devrintalen/adbusb/doc/references.md

References and Further Reading {#references}
==============================

I've broken this out into different sections. This first set of links
covers your basic introductory material for Apple Desktop Bus:

* http://en.wikipedia.org/wiki/Apple_Desktop_Bus
* http://www.microchip.com/stellent/idcplg?IdcService=SS_GET_PAGE&nodeId=1824&appnote=en011062
* http://mcosre.sourceforge.net/docs/adb_intro.html

This set of links is of other projects that have done similar things
with Apple Desktop Bus:

* http://geekhack.org/showwiki.php?title=Island:14290
* http://spritesmods.com/?art=macsearm&page=4
* https://github.com/tmk/tmk_keyboard

And this final set is of materials that are relevant to the USB
firmware and the AVR:

* http://www.obdev.at/products/vusb/hidkeys.html
* [Atmel AVR042: AVR Hardware Design Considerations](http://www.atmel.com/Images/doc2521.pdf) (pdf)
* http://www.usb.org/developers/docs/hidpage/
