devrintalen/adbusb/doc/keyboard_layout.rst

Keyboard Layout
---------------

      --------- function keys -----------
<esc> 1 2 3 4 5 6 7 8 9 10 11 12 13 14 15

~ 1 2 3 4 5 6 7 8 9 0 - + <del>         <help> <hom> <pgup>     <c> = / *
<tab> q w e r t y u i o p [ ] \         <del>  <end> <pgdn>     7 8 9 -
<cap> a s d f g h j k l ; ' <ret>                               4 5 6 +
<shift> z x c v b n m , . / <shift>        ^                    1 2 3 <ent>
<ctrl> <o> <c> <space> <c> <o> <ctrl>   <- v ->                 0   .

Keycodes
--------

35 7a 78 63 76 60 61 62 64 65 6d 67 6f 69 6b 71

32 12 13 14 15 17 16 1a 1c 19 1d 1b 18 33   72 73 74    47 51 4b 43
30 0c 0d 0e 0f 11 10 20 22 1f 23 21 1e 2a   75 77 79    59 5b 5c 4e
39 00 01 02 03 05 04 26 28 25 29 27 24                  56 57 58 45 
38 06 07 08 09 0b 2d 2e 2b 2f 2c 38            3e       53 54 55 4c
36 3a 37 31 37 3a 36                        3b 3d ??    52 41
