devrintalen/adbusb/(list of files, drawings)

Other design files:
schematic/board_mega32.pcb
