devrintalen/adbusb/code/main.c

// Copyright 2009 Devrin Talen
// This file is part of ADBUSB.
// 
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
/*! 
  \file main.c
  \brief Main program source.
*/

#include <stdlib.h>
#include <stdint.h>
#include <stdio.h>
#include <avr/wdt.h>

#include "adb.h"
#include "keyboard.h"
#include "uart.h"
#include "usb.h"

/// File handle to UART device
static FILE uart_str = FDEV_SETUP_STREAM(uart_putchar, NULL, _FDEV_SETUP_WRITE);

/*! \brief Reset entry point.
  
  At reset the device starts executing at this point. This will call
  initializers to disable the watch dog timer and enable the ADB and
  USB interfaces. The watch dog timer is a nice feature to have but it hasn't been necessary (yet) for this project.

  The function usb_init() handles all of the USB interface initialization. No other global state is necessary for 
  The ADB interface is set up by declaring and initializing the variables that the data returned by the keyboard. The adb_init() function is then called, which will handle the reset tasks on the line.


It then enters the main
  loop and polls the ADB device and sends data on the USB interface as
  needed.
*/
int main(void)
{
  // Initialize watchdog timer.
  wdt_disable();

  // Initialize USB.
  usb_init();

  // Initialize ADB.
  uint8_t adb_status = 0;
  uint8_t adb_len;
  uint8_t adb_data[8];
  adb_init();

  // Initialize UART.
  uart_init();
  stdout = &uart_str;
    
  printf("ADBUSB v0.4\n");
  printf("Copyright 2011-12 Devrin Talen\n");

  while(1) {
    usbPoll();
    /* ADB phase. */
    if (usbInterruptIsReady()) {
      adb_status = adb_command(2, ADB_CMD_TALK, 0);
    }
    if (adb_status != 0) {
      adb_status = adb_read_data(&adb_len, adb_data);
      if (adb_status == 0) {
    	if (adb_len == 16) {
    	  kb_register(adb_data[0]);
    	} else {
    	  //kb_reset();
    	}
      }
    }
    /* USB phase. */
    if (usbInterruptIsReady()) {
      keybReportBuffer.meta = kb_usbhid_modifiers();
      kb_usbhid_keys(keybReportBuffer.b);
      usbSetInterrupt((void *)&keybReportBuffer, sizeof(keybReportBuffer));
      keybReportBuffer.b[0] = 0;
    }
  }

  return 0;
}
