devrintalen/adbusb/code/adb.h

// Copyright 2009 Devrin Talen
// This file is part of ADBUSB.
// 
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
/*!
  \file adb.h
  \brief Global routines for the ADB interface.
*/

#ifndef __inc_adb__
#define __inc_adb__

/// Output port
#define ADB_PORT PORTB
/// Output low value
#define ADB_TX_0 0x0
/// Output high value
#define ADB_TX_1 0x4

/// 2b code for a flush command.
#define ADB_CMD_FLUSH 0
/// 2b code for a listen command.
#define ADB_CMD_LISTEN 2
/// 2b code for a talk command.
#define ADB_CMD_TALK 3

/**
   Send a command packet and receive data if sent. Constructs a command
   packet and sent according to the ADB specification:
  
   -# Assert attention signal (800us).
   -# Assert sync signal (70us).
   -# Send command byte (8 * 100us).
   -# Send stop bit (100us).
   -# Release line.
  
   After sending the command packet, this will wait for data to be 
   returned. If the device begins sending data then this will begin 
   recording it. The specification states that we must wait between
   160us and 240us for the device to start. A response packet looks like:
  
   -# Start bit (1)
   -# Two to eight bytes of data, sent in order of 0 to 7. Each byte is
      sent MSB first.
   -# Stop bit (0)
  
   Returned data is stored in adb_rx_data. The number of bits received
   is available in adb_rx_count.
  
   This code uses timer0 and INT2 to make this call non-blocking.
   Once the attention signal has been started this call will return.
   Successive calls will return non-zero status until the state machine
   reaches idle again.
  
   @param[in]  address Device address.
   @param[in]  command Command to send.
   @param[in]  reg     Register to read/write.
   @return     0 for success.
*/
int8_t adb_command(uint8_t address, uint8_t command, uint8_t reg);


/**
   Read received data. After an ADB command completes any received
   data will be stored into a temporary buffer. In order to get at
   this data this function must be called. This copies the ADB data
   and bit count from the temporary buffer into whatever is passed.

   The ADB state machine will not send another command while there 
   is data waiting in the buffer. Likewise, this function will return
   a non-zero value if the ADB state machine is not done sending a
   command.
  
   @param[in] *len Pointer to store the bit count.
   @param[in] buff Pointer to a uint8_t[8] buffer.
   @return         0 if data was copied, 1 otherwise.
*/
int8_t adb_read_data(uint8_t *len, uint8_t *buff);


/**
   Initialize resources. This routine initializes the microprocesser 
   resources used by the ADB code and performs the ADB bringup sequence. 
   This consists of:
  
   -# Raise the line and remain stable for 1s.
   -# Perform reset pulse for 4ms (spec states 3ms, but actual Mac II
      hardware will do 4ms).
   -# Raise line.
  
   In addition to setting the ADB processor state interrupts will be enabled.
  
   @return 0 for success.
*/
int8_t adb_init(void);

#endif
