devrintalen/adbusb/(commit log)

2009-10-29 Successfully wrote program to device.
2009-11-01 Cleaned up the code.
    - Fixed up delay macros
    - Added necessary include statements
    - Added output to portc
    [adb.c]
2009-11-03 Added call to poll ADB device.
2009-11-07 Timing is now much closer to being correct
    - Moved clock speed definition to makefile
    - Changed frequency to 1MHz (not sure why this is better)
    [adb.c]
2009-11-14 Communication progress.
    - Keyboard doesn't seem to be able to send all of its data anymore.
    - Sends a low pulse but nothing else
    - This is sent forever until reset
    - MCU sees low pulse on INT0 (now it's time to write the rx code).
    [adb.c]
2010-01-16 Got the mouse to respond!
    Made the following changes:
    - Output port #defines were all messed up. Changed to port C.
    - Sync pulse was running long so I shortened up the macro.
    - Using STK500 Vtg/Gnd as power source for mouse.
    - Changed boot sequence to:
    - 100ms high
    - 4ms low (reset pulse)
    - 1ms interval between polling
    [adb.c, main.c]
2010-01-19 Added UART driver.
    AVR-libc really rocks. I've added a UART driver, allowing me to use printf()
    to make debug statements. Don't know if this compiles still (would be
    surprised if it did!).
2010-01-21 Got UART code to compile. Doesn't appear to work.
    [adb.c, adb.h, uart.c, uart.h]
2010-01-21 Revert "Added UART driver."
    This reverts commit a1e9f8d22e9698017a2a1afa4c246c21ad6435a6.
    Conflicts:
    code/uart.c
    code/uart.h
    [main.c, uart.c, uart.h]
2010-01-22 Rewrote ADB receive code.
    Using a system of interrupts now:
    - Trigger on rising edge to detect a received bit.
    - Trigger every 100us to record bit and check if we're still receiving.
2010-01-23 Small fixes to rx code.
    [adb.c]
2010-01-23 Fixed syntax errors. Now compiles.
    [adb.c]
2010-01-24 Changes related to external interrup 0 code.
    Had to change two things:
    1. Moved the ADB port to D because it's where the external interrupt 0 pin is
    located.
    2. Re-worked the int0 enable code so that it wouldn't fire inappropriately.
2010-04-21 Seems to be reading bits correctly!
    It sure is ugly but it appears to be able to parse out "0" and "1" bits
    correctly on the data line. Doesn't yet know how to stop.
    [adb.c]
2010-04-21 Now stops correctly after a data packet!
    Timing might still be dependent on timing variations from debug statements.
    Need to try removing these but need a way to view received packet (UART?).
    [adb.c]
2010-05-17 Fixed rest of conflicts with master.
    [main.c]
2010-05-21 Got something to transmit on the uart!
    Ok so it really sucks. Somehow setting the baud rate to 600 (not 9600) on the
    computer side works for single characters (haven't tried more yet). Must be
    something messed up with the baud rate calculation on the mega32 side.
2010-05-25 Finally got the stupid uart working.
    Problem was with the fuse programming. Added an entry to the Makefile to fix
    it. Basically you need to program the CKSEL bits to 0000, or else it'll use
    the built-in 1MHz oscillator. This will affect a bunch of the rx code.
2010-05-26 Adding uart header file.
    Why in the world was this not included. WTF mate
2010-05-26 Abstracted ADB port.
    Created #defines ADB_PORT and ADB_PIN so it's easier to move this port around.
    Had to move it because the UART now takes port D. ADB is now on port B.
2010-05-26 Bringing rx code back up to speed (ha).
    With everything running 16x faster the rx code was running too fast. Modified
    some stuff and think it works OK. Need to do testing to confirm.
    [adb.c]
2010-06-03 Rx code works with updated fuse settings.
    Now that everything is running 16x faster the receive code had to be updated
    to work with the new timing. Everything seems to work at the moment (at least
    when receiving two bytes from a mouse).
2010-06-05 adb_poll() was returning the wrong value.
    adb_poll() was returning 1 if data was received, whereas it should
    have been returning 0. main() was following along, so that had to
    be changed as well.
    [adb.c, main.c]
2010-06-05 Improved documentation on adb_tx and rx.
    Documented how long each may block while executing (answer: a lot).
    Also made a pretty lengthy debug PORTA thing much shorter.
    [adb.c]
2010-06-08 Typos fixed in main()
    [main.c]
2011-04-05 Got a response from a mouse!
    This is a hacky commit, but I don't want to lose any progress. Changed:
    - Lengthened polling period to 5s.
    - Used PORTC to flash some blinkin' LEDs.
    - Changed the default address to 0x3 to target the mouse.
    And most importantly: switched mice. Now using "Pinky".
2011-04-08 Fixed a bug that caused data to be off by one bit
    [adb.c]
2011-04-09 Read "hello world" from the keyboard!
    Coded up a simple translation function in a keyboard library. Only returns
    printable chars. Can't use the shift keys. Proves that the keyboard works!
2011-06-05 Cleaning up fuse settings.
2011-06-05 Committing logic sniffer trace.
2011-07-23 Added more USB functionality.
    - Expanded USB driver code.
    - Hacked up main() to only do USB stuff.
    - Edited the usb defines to act as a keyboard.
    - Plugged it in and the descriptor was (mostly) recognized.
    - Added a few new routines to the keyboard library.
2011-08-06 Control key works!
    The USB code successfully pressed the left control key! This is pretty cool.
    - Switched the descriptor report to the HID keyboard one.
    - Ripped out mouse code.
    - Updated usbconfig.h with the new report length.
2011-08-06 Cleaning up files.
    - Moved usb code out of main.c into usb.c.
    - Cleaned up header files and added ifdefs to prevent including twice.
    [adb.h, keyboard.h, main.c, uart.h, usb.c, usb.h]
2012-01-13 It prints "hello world". There was much rejoicing.
2012-01-14 Cleaned and tightened up the code a bit.
    [keyboard.c, keyboard.h, main.c, usb.c, usb.h]
2012-01-14 Beginning to merge ADB and USB code.
    Started with USART code. Have the USART and USB code working together, at least for printing out the copyright header at reset. Haven't tried anything during the poll loop.
    [main.c]
2012-01-15 It works! I typed "hello world"!
    - Enabled both ADB and USB code in main().
    - Fixed a little bug in kb_register() that stopped processing all translations.
    - Added some printfs to kb_register() but guarded them with #ifdef DEBUG.
    [keyboard.c, keyboard.h, main.c]
2012-01-15 Fixed a bug with modifier keys.
    [keyboard.c]
2012-01-21 Fixed a bug: #ifdef -> #if
    [keyboard.c]
2012-01-22 In the process of debugging some USB/ADB conflict.
    - Removed assert() calls from ADB (why did I even have these?)
    - Added a lot of LED debug stuff to ADB.
    - Added something to the Makefile to fix the STK500 when it borks.
    [adb.c, main.c, usbconfig.h]
2012-02-12 Migrating ADB code to use timers and interrupts.
2012-02-27 Interrupt-based tx code seems to be working.
2012-02-27 More interrupt-based code and fixes.
    - Fixed tx code to send MSB first.
    [adb.c]
2012-02-27 Moving around LED debug output.
2012-02-27 Got external interrupt INT2 working somewhat.
2012-02-27 Fixed a bug that hung us after receiving data.
    [adb.c]
2012-02-27 New rx code is kind of working.
    - Doesn't look like it's classifying 0s and 1s correctly yet.
    - Bit count is consistently 18 and that sounds too high.
    [adb.c, main.c]
2012-02-27 Fixed a stupid logic inversion bug.
    [adb.c]
2012-02-28 RX code now works correctly.
    - Had to fix up the bit twiddling.
    - Chomps off start and stop bits now.
    [adb.c]
2012-02-28 Wrapping up. Major restructuring = done.
    - Changed how main() interfaces with ADB code.
    - Removed adb_poll(). Just uses adb_command() now.
    - New function adb_read_data() to get rx data.
    - Updated about half the ADB documentation.
    All that's left is to see if it actually made the USB/ADB interference
    go away!
    [adb.c, adb.h, main.c]
2012-03-01 Made changes to ADB API.
    - Now main() has to copy received data via a new call.
    - Made timer0 and int2 interrupts non-blocking.
2012-03-01 Taking some new traces with a different trigger.
2012-03-01 USB code works alongside ADB code!!
    - Had to make ADB interrupts non-blocking.
    - Required some speedup and tuning.
    - Had to add kb_reset() to clear out keyboard state when ADB returns junk.
2012-03-10 Making progress on ADB/USB interference.
    Still very frustrated at it. The USB HID won't be recognized
    unless there's a second USB device plugged in as well. WTF.
    [adb.c, adb.h, main.c]
2012-03-22 Rock-solid communication.
    The code is now rock-solid and doesn't hang. Here are the changes:
    - Moved ADB poll code to immediately follow a USB interrupt. This
    prevents USB interrupts (every 10ms) from ever happening during
    ADB polling.
    - Fixed my breadboard to include a 4.7uF capacitor between V+ and
    GND. There was some sort of electrical issue where the host
    would only recognize the USB device if there was another USB
    device plugged in (like my USB programmer).
    - While I had the soldering iron out I also moved the pull-up
    resistor in the USB circuit to connect to port D0. This allows
    the USB code to use usbDeviceDisconnect() to simulate a USB reset
    request.
    [adb.h, main.c, usb.c, usbconfig.h]
2012-10-27 First pass at schematic and pcb.
    Created a new directory, schematic/, that holds the design files.
    This includes circuit_mega32.sch which is a schematic based on an
    Atmel Mega32, and a pcb design based on that schematic. The packages
    subdirectory includes footprints for some elements in the design.
    [board_mega32.pcb, circuit_mega32.sch]
2012-10-28 Adding documentation for the schematic
2012-10-29 Working on circuit documentation now
2013-02-15 Updating documentation
    - Continued moving all the documentation to Markdown
    - Beefed up the schematics and circuits section
    - Fixed up some references
2013-02-22 Updated circuit and PCB layout
    - Increased components to at least 1206 size.
    - Fixed the footprint of the AVR chip.
    - Fixed the orientation of the minidin connector.
    - Redid most of the layout.
    [board_mega32.pcb, circuit_mega32.sch]
2013-02-24 Fixes for errors after moving to avr-gcc 4.7.2
    - Have to declare PROGMEM stuff as const
    - Had to add some extern statements as well
    [keyboard.c, usb.c, usbdrv.c]
